SuperHouse/PCD/README.md

PiCAN Display Hat for Raspberry Pi
==================================
Designed by Jonathan Oxer <jon@oxer.com.au>

FEATURES
--------

Supply power via CAN bus, screw terminals, 2.1mm DC jack, or the
PoE header on Raspberry Pi 3 B+. Regulates down to 5V to supply the
Raspberry Pi.

TCAN332 + MCP2515 based CAN bus interface.

0.96" I2C OLED.

INSTALLATION
------------
The design is saved as an EAGLE project. EAGLE PCB design software is
available from www.cadsoftusa.com free for non-commercial use. To use
this project download it and place the directory containing these files
into the "eagle" directory on your computer. Then open EAGLE and
navigate to the project.

DISTRIBUTION
------------
The specific terms of distribution of this project are governed by the
license referenced below.

LICENSE
-------
Licensed under the TAPR Open Hardware License (www.tapr.org/OHL).
The "license" folder within this repository also contains a copy of
this license in plain text format.
