SuperHouse/PCD/PCD.brd

## EAGLE design PCD.brd (2020-03-18)

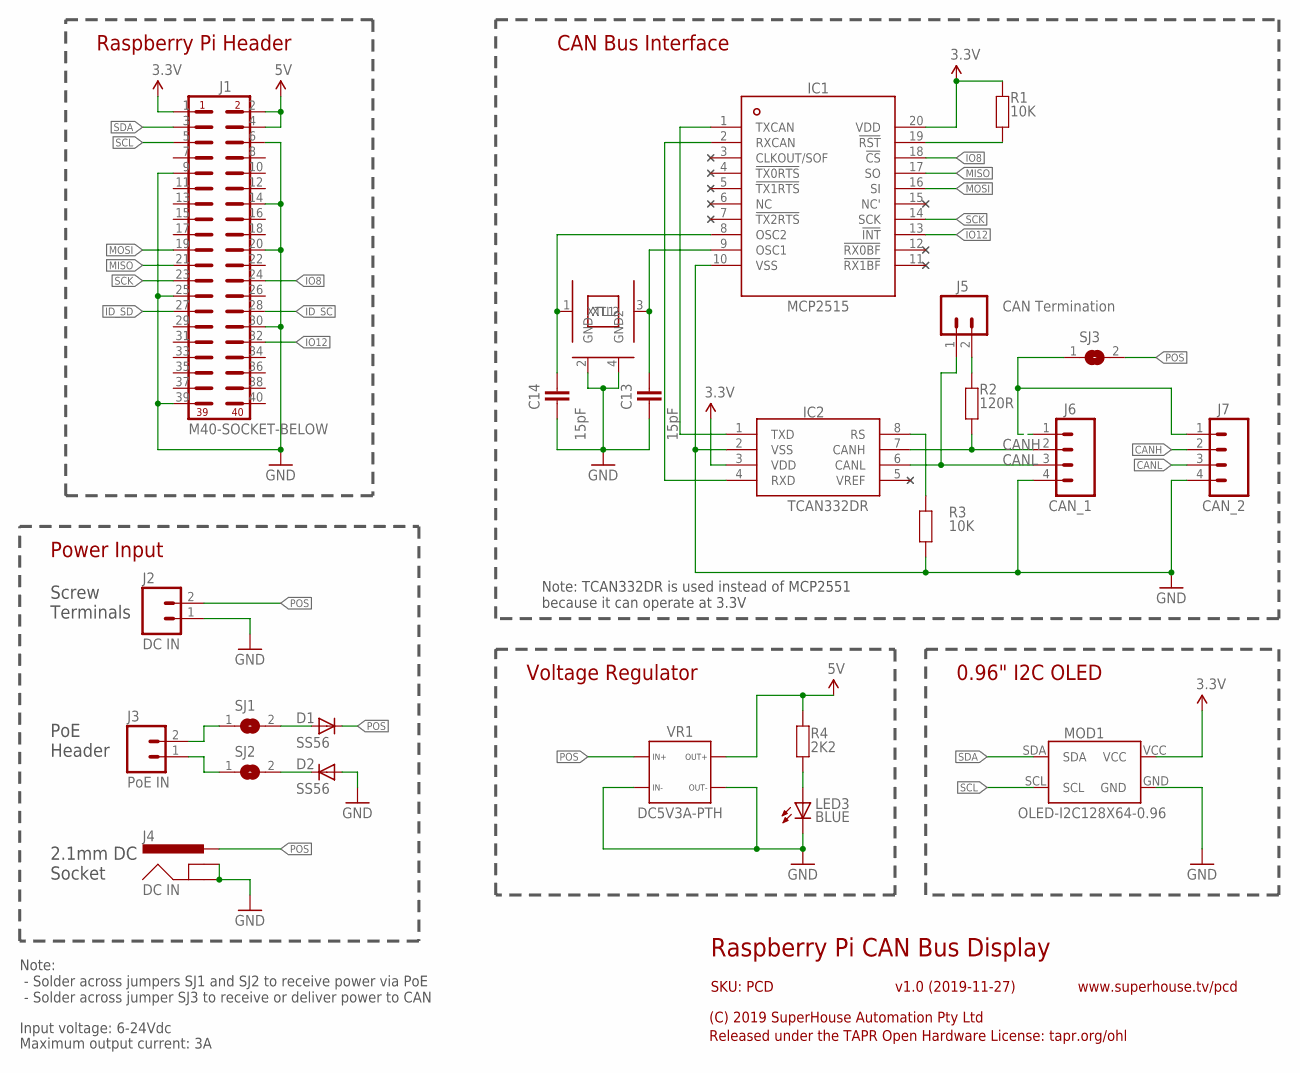
[picture p1: schematic PCD.sch]

Parts:
C13, C14: 15pF; C0603
D1, D2: SS56; SMA-DIODE
IC1: MCP2515; TSSOP20
IC2: TCAN332DR; SO08
J1: M40-SOCKET-BELOW; 2X20-S-BELOW
J2: DC IN; SCREWTERMINAL-3.5MM-2
J3: PoE IN; 1X02-S-BELOW
J4: DC IN; POWER_JACK_SLOTS
J5: CAN Termination; 1X02-P
J6: CAN_1; 1X04-P
J7: CAN_2; 1X04-P
LED3: BLUE; LED-0603
MOD1: OLED-I2C128X64-0.96; OLED-128X64-0.96
R1, R3: 10K; R0603
R2: 120R; R0603
R4: 2K2; R0603
SJ1, SJ2, SJ3: SJN; SJ
VR1: DC5V3A-PTH
XTL3: 16MHz; CRYSTAL-SMD-3X2

Connections:
3.3V: IC1.20 (VDD), IC2.3 (VDD), J1.1, MOD1.VCC, R1.2
5V: J1.2, J1.4, R4.1, VR1.3A (3), VR1.3B (3)
CANH: IC2.7 (CANH), J6.2, J7.2, R2.1
CANL: IC2.6 (CANL), J5.1, J6.3, J7.3
CAN_PWR: J6.1, J7.1, SJ3.1
GND: C13.1, C14.1, D2.A, IC1.10 (VSS), IC2.2 (VSS), J1.6, J1.9, J1.14, J1.20, J1.25, J1.30, J1.39, J2.1, J4.GND, J4.GNDBREAK, J6.4, J7.4, LED3.C, MOD1.GND, R3.1, VR1.1A (1), VR1.1B (1), VR1.4A (4), VR1.4B (4), XTL3.2 (GND), XTL3.4 (GND2)
ID_SC: J1.28
ID_SD: J1.27
IO8: IC1.18 (!CS), J1.24
IO12: IC1.13 (!INT), J1.32
MISO: IC1.17 (SO), J1.21
MOSI: IC1.16 (SI), J1.19
unnamed: J3.1, SJ2.1
unnamed: J3.2, SJ1.1
unnamed: J5.2, R2.2
unnamed: D1.A, SJ1.2
unnamed: D2.C, SJ2.2
unnamed: IC2.8 (RS), R3.2
unnamed: IC1.1 (TXCAN), IC2.1 (TXD)
unnamed: IC1.2 (RXCAN), IC2.4 (RXD)
unnamed: C13.2, IC1.9 (OSC1), XTL3.3 (XTL2)
unnamed: C14.2, IC1.8 (OSC2), XTL3.1 (XTL1)
unnamed: IC1.19 (!RST), R1.1
unnamed: LED3.A, R4.2
POS: D1.C, J2.2, J4.PWR, SJ3.2, VR1.2A (2), VR1.2B (2)
SCK: IC1.14 (SCK), J1.23
SCL: J1.5, MOD1.SCL
SDA: J1.3, MOD1.SDA

Notes on the sheet:
Raspberry Pi CAN Bus Display
v1.0 (2019-11-27)
(C) 2019 SuperHouse Automation Pty Ltd
Released under the TAPR Open Hardware License: tapr.org/ohl
www.superhouse.tv/pcd
SKU: PCD
Raspberry Pi Header
Input voltage: 6-24Vdc
Maximum output current: 3A
Screw Terminals
PoE Header
2.1mm DC Socket
Power Input
Voltage Regulator
Note: - Solder across jumpers SJ1 and SJ2 to receive power via PoE - Solder across jumper SJ3 to receive or deliver power to CAN
CAN Bus Interface
Note: TCAN332DR is used instead of MCP2551 because it can operate at 3.3V
0.96" I2C OLED

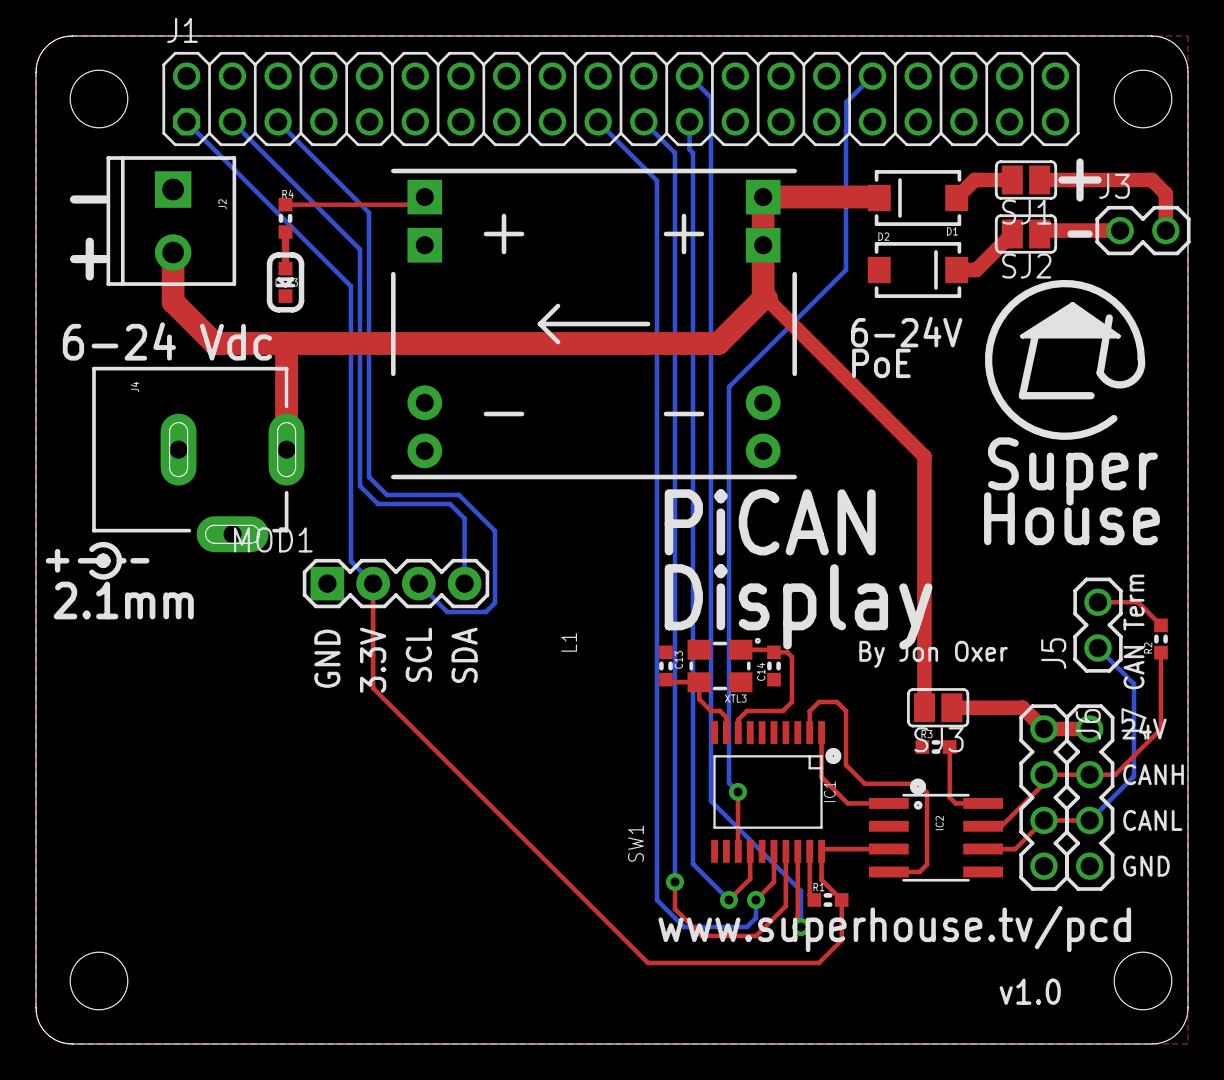
[picture p2: board PCD.brd from above]

Board: 2 copper layers, 64.0 x 56.0 mm, 24 parts (0 on the bottom side), 26 nets.
