SuperHouse/PCD/PICANDISPLAY.brd

## EAGLE design PICANDISPLAY.brd (2019-11-20)

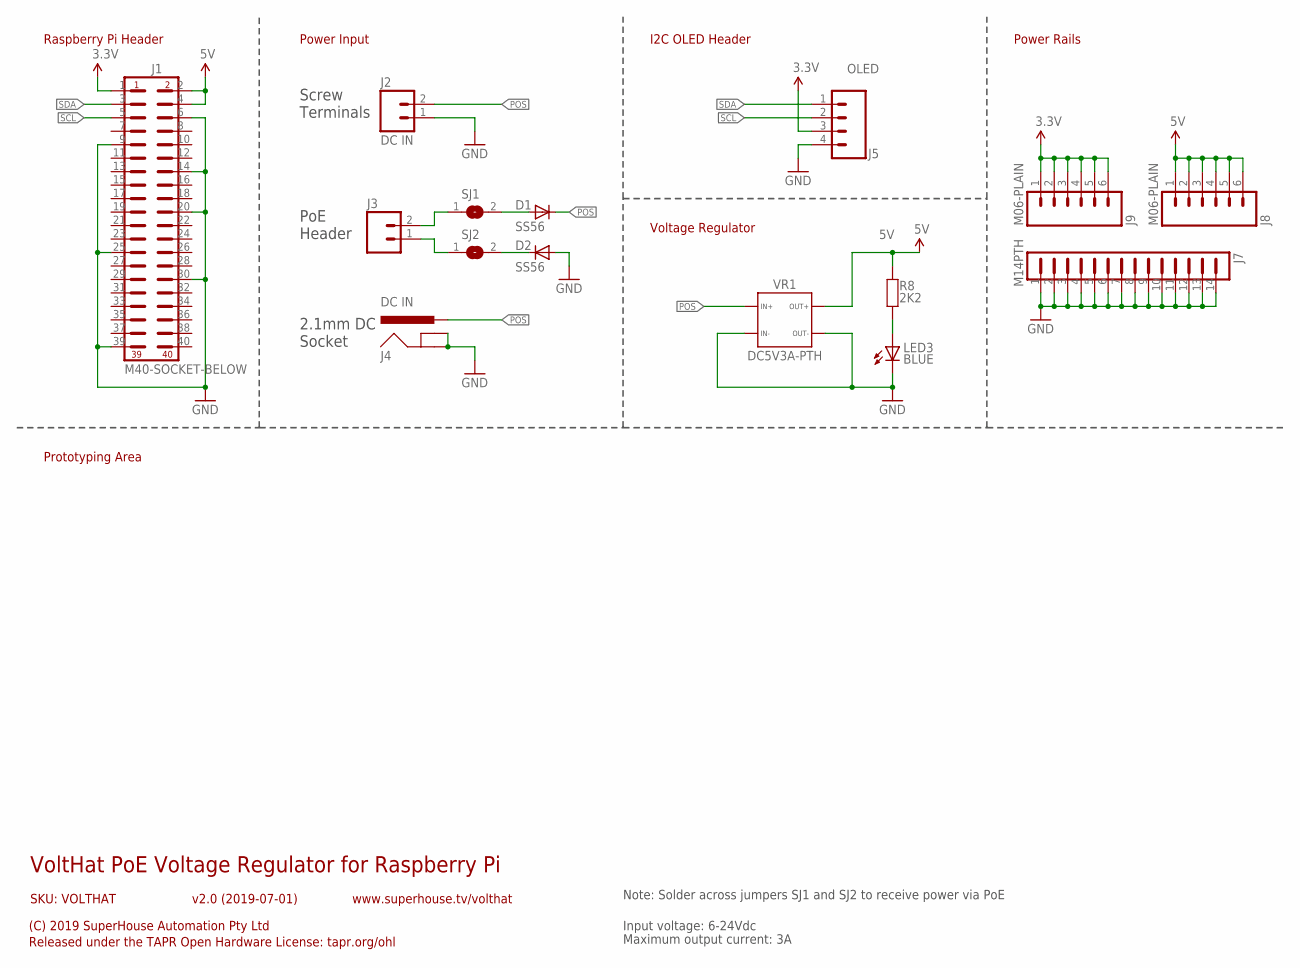
[picture p3: schematic PICANDISPLAY.sch]

Parts:
D1, D2: SS56; SMA-DIODE
J1: M40-SOCKET-BELOW; 2X20-S-BELOW
J2: DC IN; SCREWTERMINAL-3.5MM-2
J3: M02-SOCKET-BELOW; 1X02-S-BELOW
J4: DC IN; POWER_JACK_SLOTS
J5: OLED; 1X04
J7: M14PTH; 1X14
J8, J9: M06-PLAIN; 1X06
LED3: BLUE; LED-0603
R8: 2K2; R0603
SJ1, SJ2: SJN; SJ
VR1: DC5V3A-PTH

Connections:
3.3V: J1.1, J5.3, J9.1, J9.2, J9.3, J9.4, J9.5, J9.6
5V: J1.2, J1.4, J8.1, J8.2, J8.3, J8.4, J8.5, J8.6, R8.1, VR1.3A (3), VR1.3B (3)
GND: D2.A, J1.6, J1.9, J1.14, J1.20, J1.25, J1.30, J1.39, J2.1, J4.GND, J4.GNDBREAK, J5.4, J7.1 (14), J7.2 (13), J7.3 (12), J7.4 (11), J7.5 (10), J7.6 (9), J7.7 (8), J7.8 (7), J7.9 (6), J7.10 (5), J7.11 (4), J7.12 (3), J7.13 (2), J7.14 (1), LED3.C, VR1.1A (1), VR1.1B (1), VR1.4A (4), VR1.4B (4)
unnamed: J3.1, SJ2.1
unnamed: J3.2, SJ1.1
unnamed: D1.A, SJ1.2
unnamed: D2.C, SJ2.2
unnamed: LED3.A, R8.2
POS: D1.C, J2.2, J4.PWR, VR1.2A (2), VR1.2B (2)
SCL: J1.5, J5.2
SDA: J1.3, J5.1

Notes on the sheet:
VoltHat PoE Voltage Regulator for Raspberry Pi
v2.0 (2019-07-01)
(C) 2019 SuperHouse Automation Pty Ltd
Released under the TAPR Open Hardware License: tapr.org/ohl
www.superhouse.tv/volthat
SKU: VOLTHAT
Raspberry Pi Header
Input voltage: 6-24Vdc
Maximum output current: 3A
Screw Terminals
PoE Header
2.1mm DC Socket
Power Input
I2C OLED Header
Power Rails
Prototyping Area
Voltage Regulator
Note: Solder across jumpers SJ1 and SJ2 to receive power via PoE

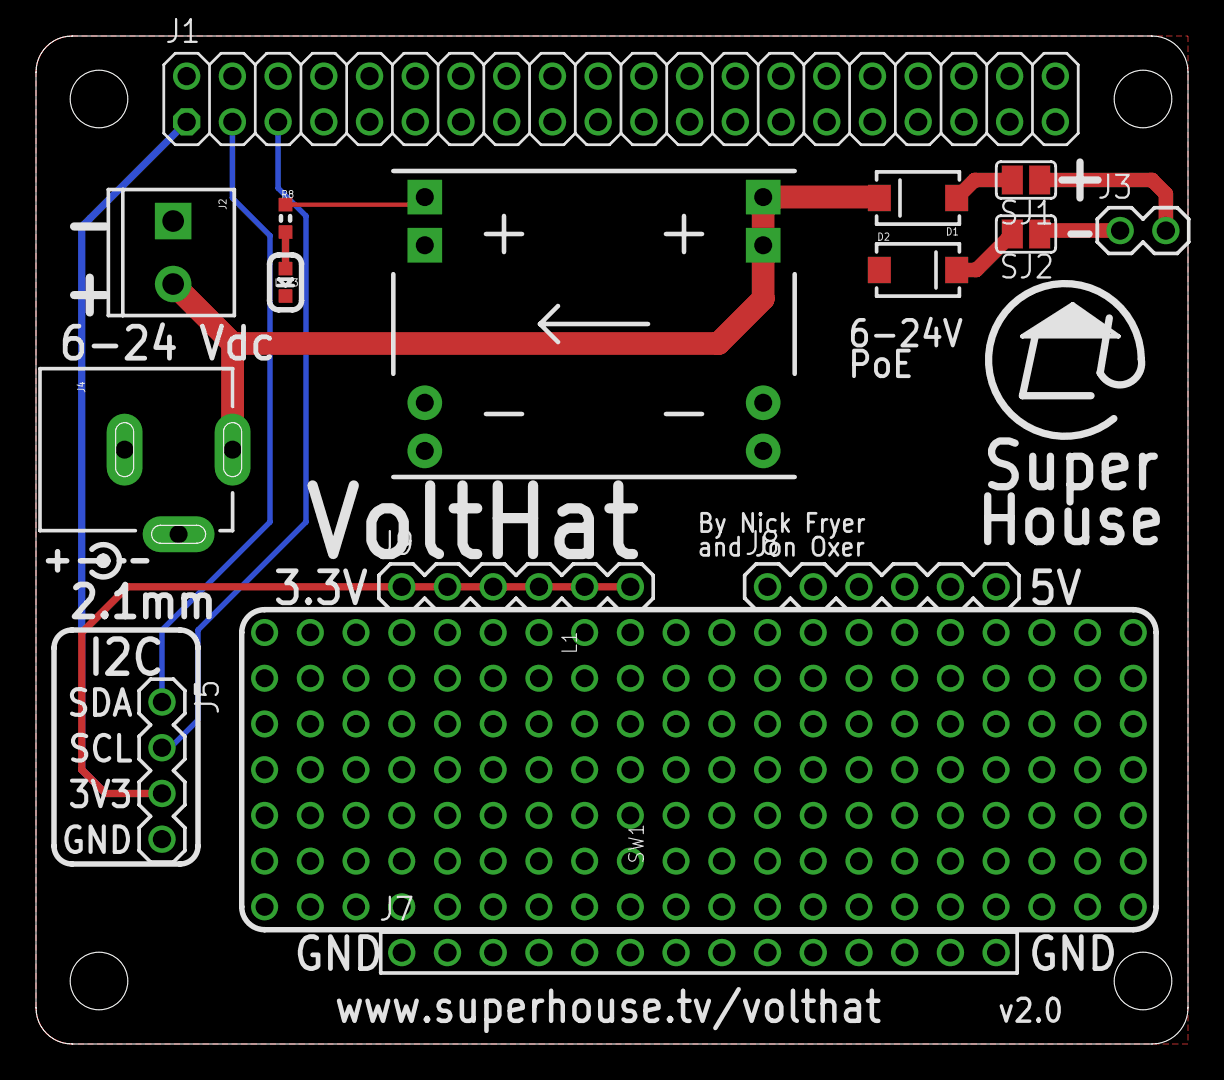
[picture p4: board PICANDISPLAY.brd from above]

Board: 2 copper layers, 64.0 x 56.0 mm, 15 parts (0 on the bottom side), 11 nets.
