SuperHouse/PCD/(commit log)

2019-11-20 Renamed files from original project
    [PICANDISPLAY.brd, PICANDISPLAY.sch]
2019-11-20 Basic schematic and routing. Time to ponder it for a while.
    [PCD.brd, PCD.sch]
2019-11-20 Silkscreen and docs
    [PCD.brd]
2019-11-20 Added nets for HAT EEPROM
    [PCD.brd, PCD.sch]
2020-03-18 Major work for v1.0 release
    [PCD.brd, PCD.sch]
