SuperHouse/PCD/(notices)

Notices in the files:
PCD.brd:
Copyright 2019 SuperHouse Automation Pty Ltd
